shashikumars/eink-desk-clock/frame/frame_front.stl

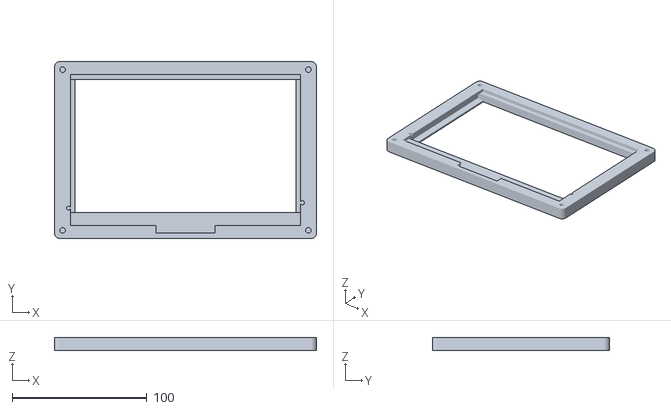
[picture p3: CAD file, 2026-11-08]
frame/frame_front.stl
194.2 x 131.2 x 10.0
