shashikumars/eink-desk-clock/frame/frame_back.stl

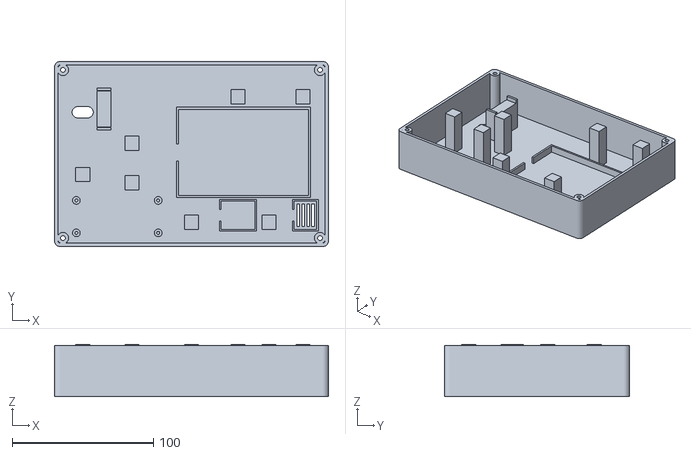
[picture p4: CAD file, 2026-11-08]
frame/frame_back.stl
194.2 x 131.2 x 37.1
